anna328p/tempsensor_esp01/tempsensor_esp01.kicad_pcb

## KiCad design tempsensor_esp01.kicad_pcb (2022-11-19)

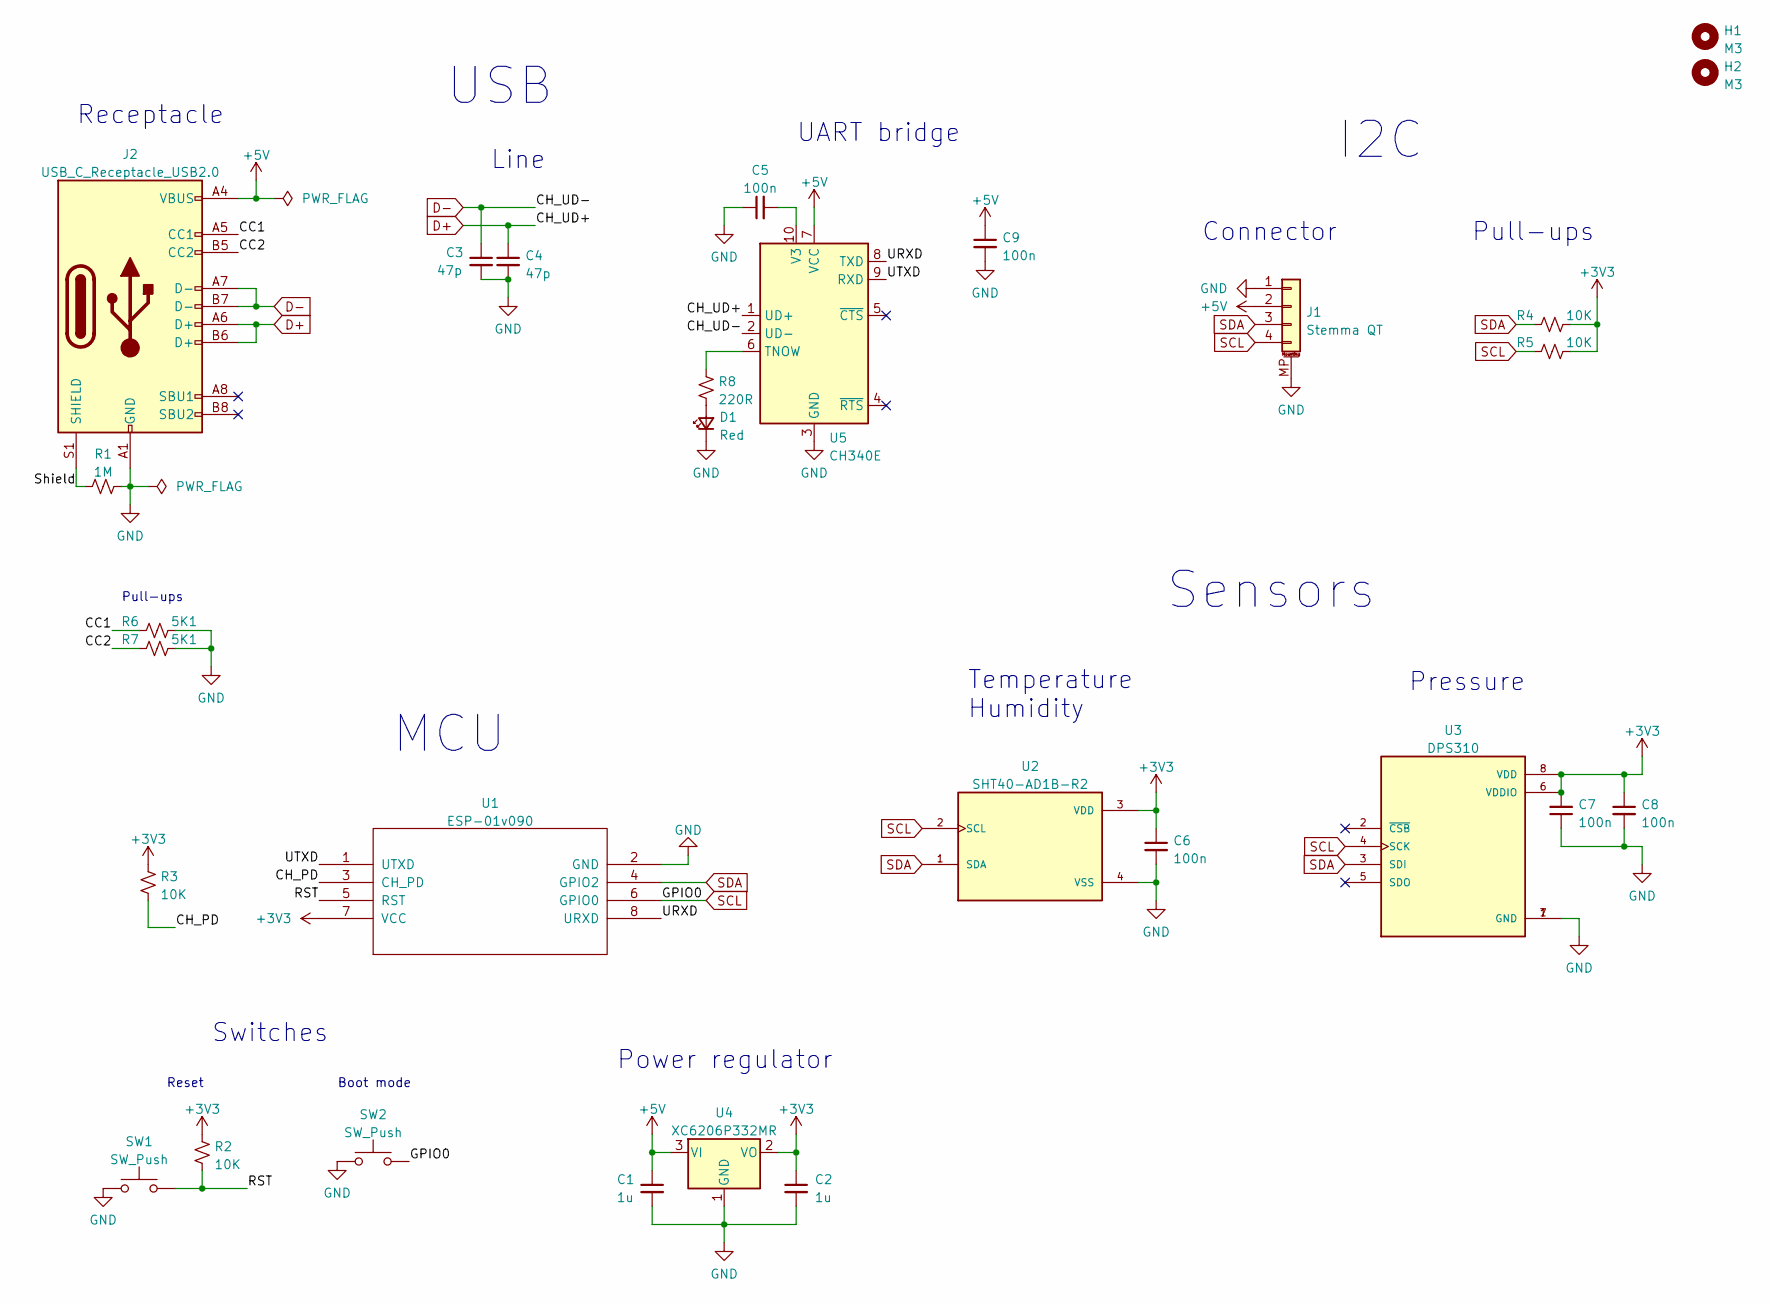
[picture p1: schematic tempsensor_esp01.kicad_sch, Environmental sensor module]

Parts:
C1, C2: 1u; C_0402_1005Metric; LCSC C52923
C3, C4: 47p; C_0402_1005Metric; LCSC C1567
C5, C6, C7, C8, C9: 100n; C_0402_1005Metric; LCSC C1525
D1: Red; LED_0603_1608Metric; LCSC C2286
H1, H2: M3; MountingHole_3.2mm_M3
J1: Stemma QT; JST_SH_SM04B-SRSS-TB_1x04-1MP_P1.00mm_Horizontal; LCSC C160404
J2: USB_C_Receptacle_USB2.0; USB_C_Receptacle_HRO_TYPE-C-31-M-12; LCSC C165948
R1: 1M; R_0402_1005Metric; LCSC C26083
R2, R3, R4, R5: 10K; R_0402_1005Metric; LCSC C25744
R6, R7: 5K1; R_0402_1005Metric; LCSC C25905
R8: 220R; R_0402_1005Metric; LCSC C25091
SW1, SW2: SW_Push; SW_Push_SPST_NO_Alps_SKRK; LCSC C115357
U1: ESP-01v090; ESP-01; LCSC C503582
U2: SHT40-AD1B-R2; XDCR_SHT40-AD1B-R2; LCSC C2909890
U3: DPS310; XDCR_DPS310; LCSC C130156
U4: XC6206P332MR; SOT-23; LCSC C5446
U5: CH340E; MSOP-10_3x3mm_P0.5mm; LCSC C99652

Connections:
+3V3: C2.1, C6.1, C7.2, C8.1, R2.1, R3.1, R4.2, R5.2, U1.7 (VCC), U2.3 (VDD), U3.6 (VDDIO), U3.8 (VDD), U4.2 (VO)
+5V: C1.1, C9.1, J1.2, J2.A4 (VBUS), J2.A9 (VBUS), J2.B4 (VBUS), J2.B9 (VBUS), U4.3 (VI), U5.7 (VCC)
/CC1: J2.A5 (CC1), R6.1
/CC2: J2.B5 (CC2), R7.2
/CH_PD: R3.2, U1.3 (CH_PD)
/RST: R2.2, SW1.2, U1.5 (RST)
/Shield: J2.S1 (SHIELD), R1.2
/URXD: U1.8 (URXD), U5.8 (TXD)
/UTXD: U1.1 (UTXD), U5.9 (RXD)
D+: C4.1, J2.A6 (D+), J2.B6 (D+), U5.1 (UD+)
D-: C3.1, J2.A7 (D-), J2.B7 (D-), U5.2 (UD-)
GND: C1.2, C2.2, C3.2, C4.2, C5.1, C6.2, C7.1, C8.2, C9.2, D1.1 (K), J1.1, J1.MP (MountPin), J2.A1 (GND), J2.A12 (GND), J2.B1 (GND), J2.B12 (GND), R1.1, R6.2, R7.1, SW1.1, SW2.1, U1.2 (GND), U2.4 (VSS), U3.1 (GND), U3.7 (GND), U4.1 (GND), U5.3 (GND)
unnamed: C5.2, U5.10 (V3)
unnamed: D1.2 (A), R8.2
unnamed: R8.1, U5.6 (TNOW)
SCL: J1.4, R5.1, SW2.2, U1.6 (GPIO0), U2.2 (SCL), U3.4 (SCK)
SDA: J1.3, R4.1, U1.4 (GPIO2), U2.1 (SDA), U3.3 (SDI)

Notes on the sheet:
Line
Sensors
Reset
UART bridge
Receptacle
Temperature Humidity
USB
Connector
Boot mode
Switches
Power regulator
Pull-ups
MCU
Pressure
I2C

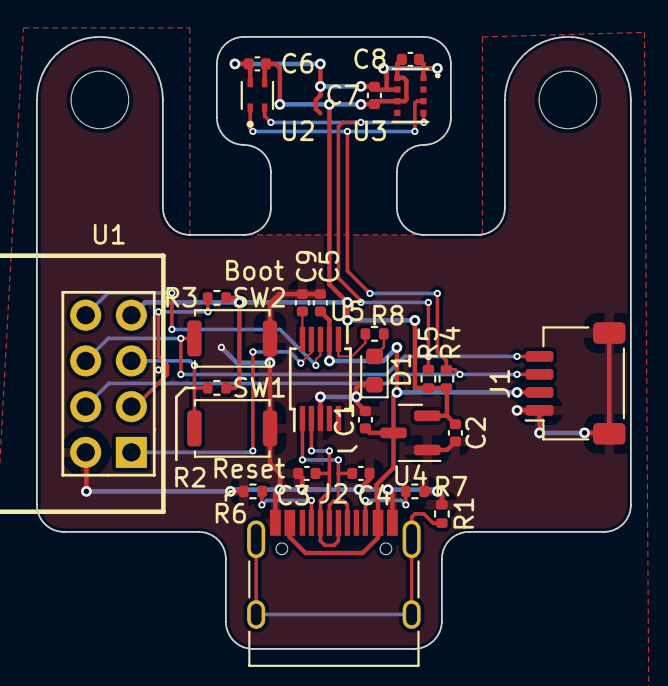
[picture p2: board tempsensor_esp01.kicad_pcb from above]

Board: 2 copper layers, 33.0 x 34.0 mm, 29 parts (0 on the bottom side), 17 nets.
