anna328p/tempsensor_esp01/(commit log)

2022-11-16 complete schematic
    [tempsensor_esp01.kicad_sch]
2022-11-18 complete board
    [tempsensor_esp01.kicad_pcb, tempsensor_esp01.kicad_sch]
2022-11-18 generate out files
    [tempsensor_esp01.kicad_pcb, tempsensor_esp01.kicad_sch]
2022-11-18 fix silkscreen
    [tempsensor_esp01.kicad_pcb]
2022-11-18 redesign using CH340E
    [tempsensor_esp01.kicad_pcb, tempsensor_esp01.kicad_sch]
2022-11-19 change power regulator
    [tempsensor_esp01.kicad_pcb, tempsensor_esp01.kicad_sch]
